HariOmChadha/LumaBot/Core/Inc/ft5336.h

#ifndef FT5336_H
#define FT5336_H

#include "stm32f7xx_hal.h"

#define FT5336_I2C_ADDR (0x70)

// returns 1 if touched, 0 if not
uint8_t FT5336_ReadTouch(uint16_t *x, uint16_t *y);

#endif /* FT5336_H */
