HariOmChadha/LumaBot/(commit log)

2026-04-03 updating the motor control to remove jitter
    [motor_control.c]
2026-04-04 add ik controller after image processing
    [my_arm.urdf]
2026-04-04 fixed the jitter
2026-04-05 smoothing the motors
2026-04-05 fixing a small bug
    [motor_control.c, motor_control.h]
2026-04-05 add logic for two modes
    [my_arm.urdf]
2026-04-07 fix ee axis bug
    [angle_compute.c, arm_test.py]
2026-04-07 fix bug for ee axis
    [angle_compute.c]
2026-04-07 fix bug for controller
    [angle_compute.c, angle_compute.h, lcd_ui.c]
